ShrapnelDSP/ShrapnelPCB/d-nmj4hcd2.stp

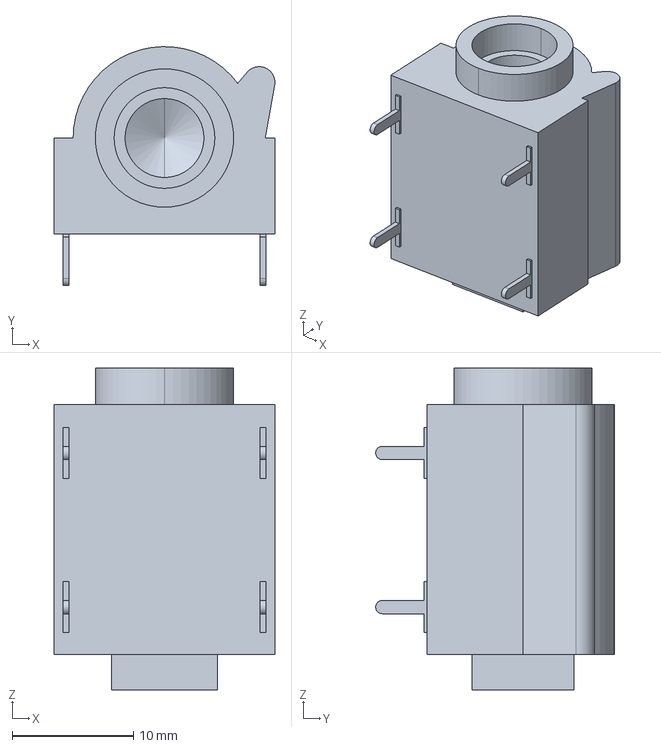
[picture p1: CAD file, 2021-09-12]
d-nmj4hcd2.stp
18.2 x 19.7 x 26.5 mm
