ShrapnelDSP/ShrapnelPCB/CUI_DEVICES_PJ-002AH-SMT-TR.step

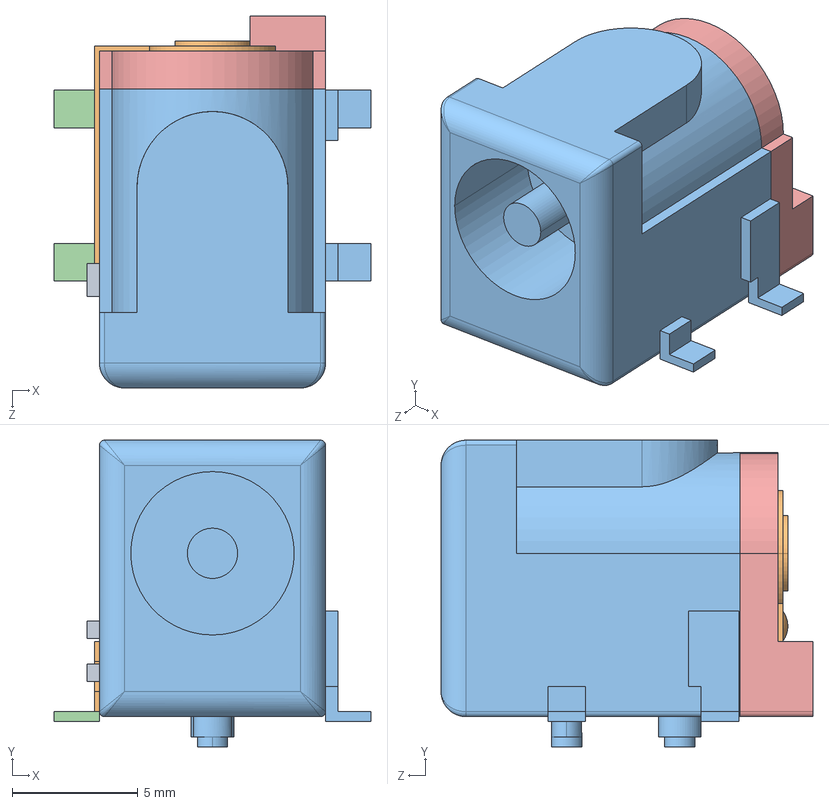
[picture p2: CAD file, 2021-09-11]
CUI_DEVICES_PJ-002AH-SMT-TR.step
12.6 x 12.2 x 14.8 mm
