ShrapnelDSP/ShrapnelPCB/57PC5F.STEP

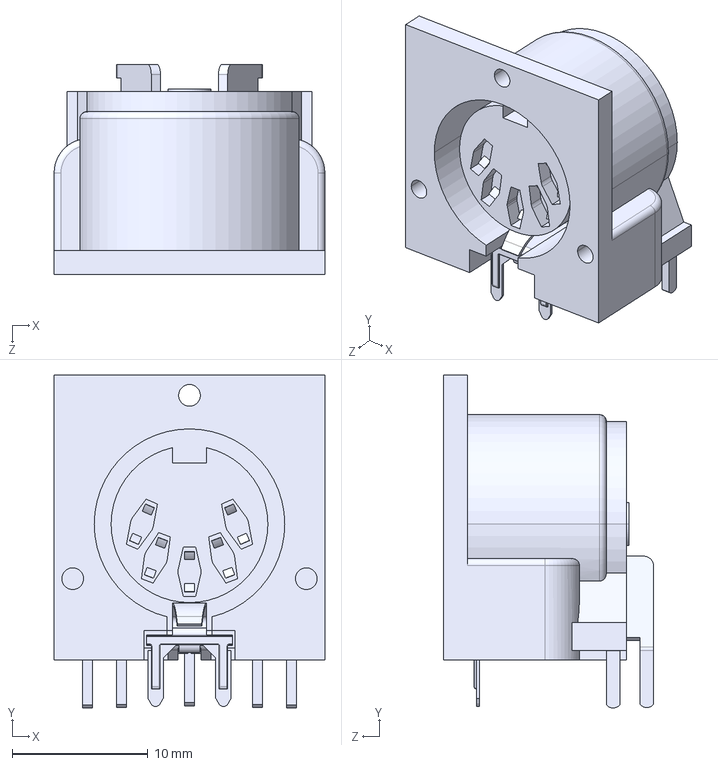
[picture p3: CAD file, 2021-08-31]
57PC5F.STEP
20.0 x 24.5 x 15.5 mm
