ShrapnelDSP/ShrapnelPCB/ESP32-Wrover-I v7.step

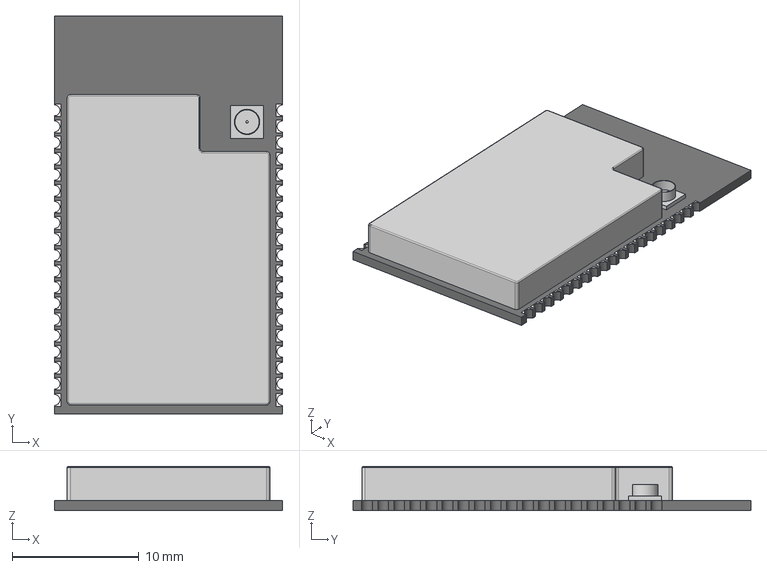
[picture p4: CAD file, 2021-08-14]
ESP32-Wrover-I v7.step
18.0 x 31.4 x 3.50 mm
