ShrapnelDSP/ShrapnelPCB/guitar_dsp_platform.kicad_pcb

## KiCad design guitar_dsp_platform.kicad_pcb (2021-10-28)

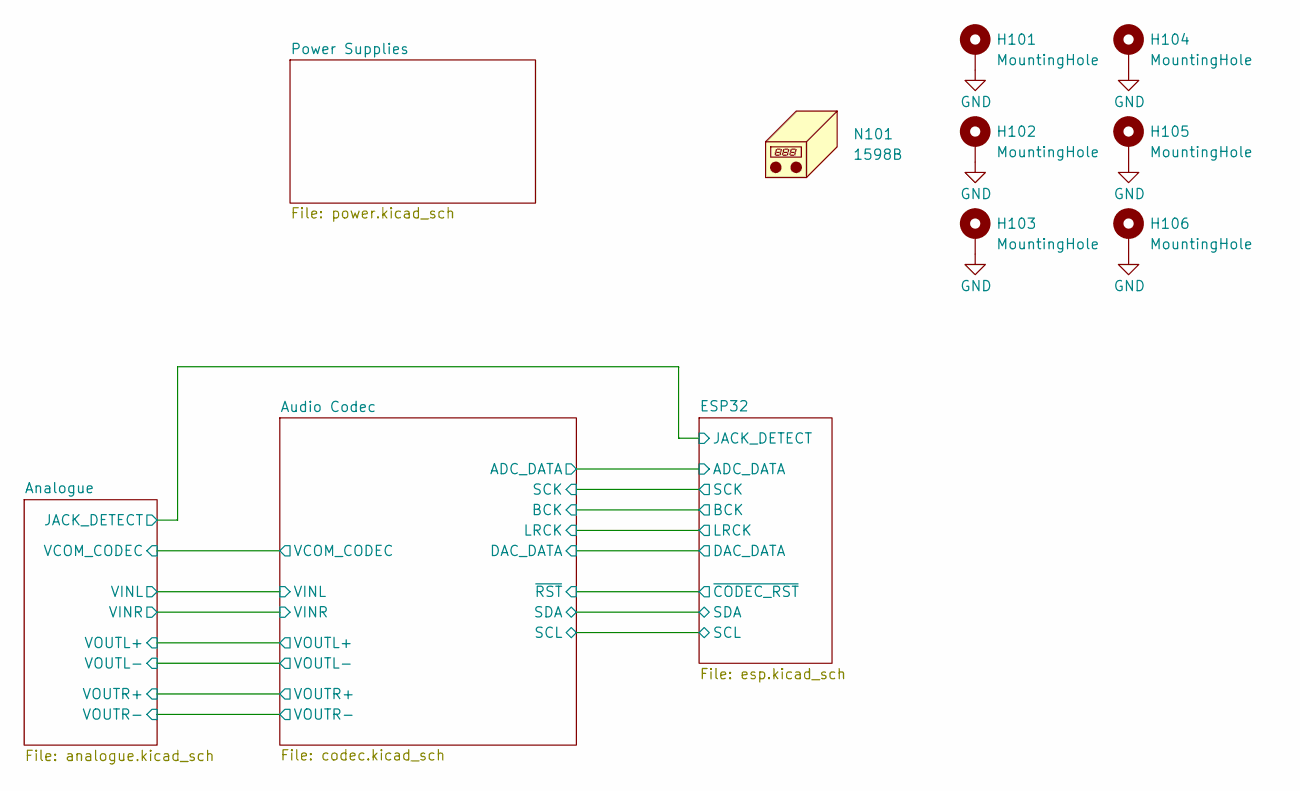
[picture p5: schematic guitar_dsp_platform.kicad_sch]

Parts:
H101, H102, H103, H104, H105, H106: MountingHole; 1598B_mounting_hole
N101: 1598B

Connections:
GND: H101.1, H102.1, H103.1, H104.1, H105.1, H106.1; also elsewhere on the board

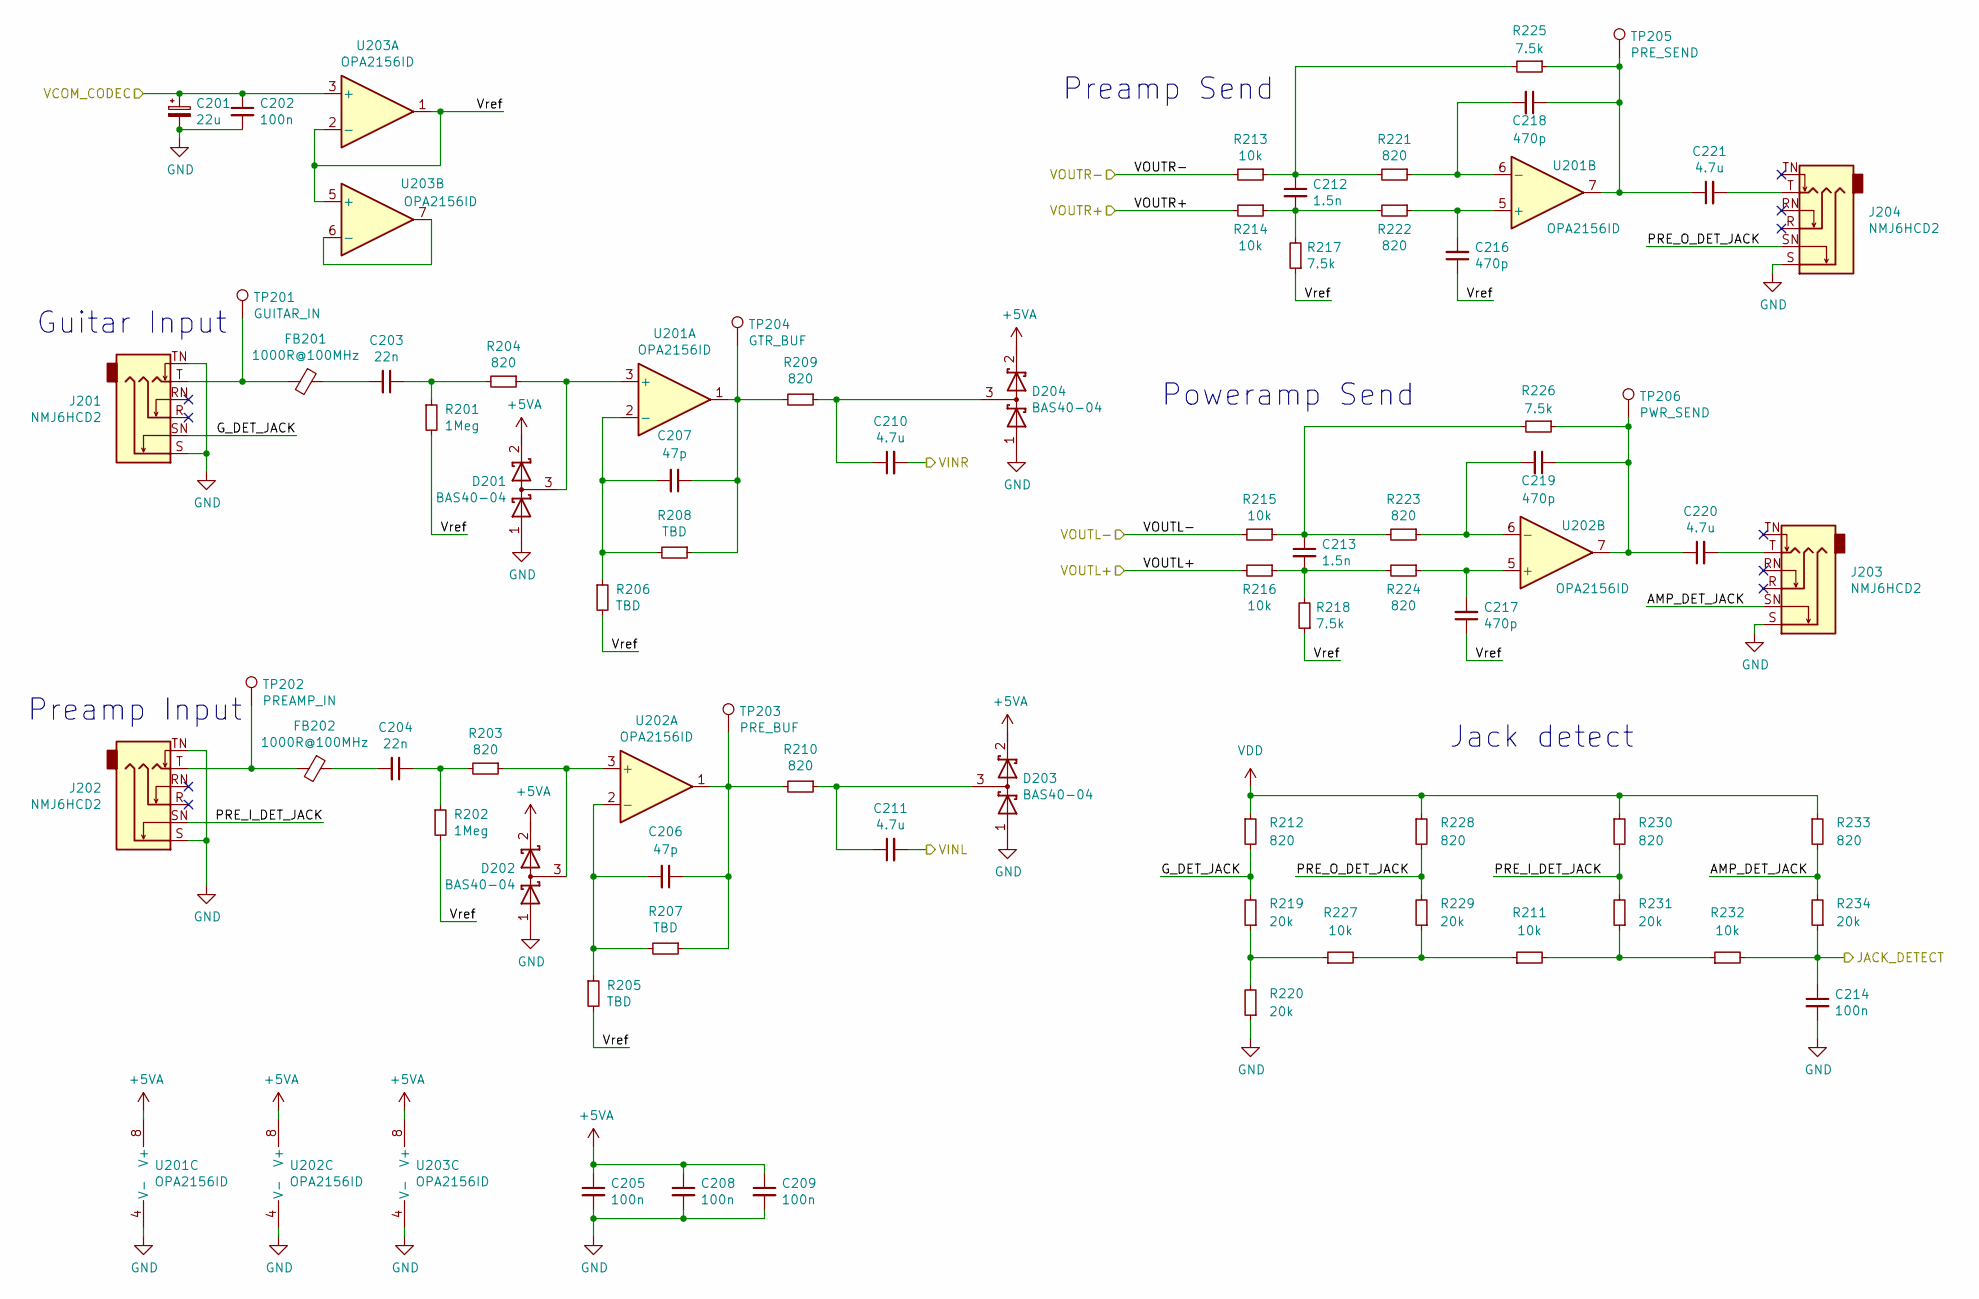
[picture p6: schematic analogue.kicad_sch]

Parts:
C201: 22u; CP_Elec_4x5.8
C202, C205, C208, C209, C214: 100n; C_0805_2012Metric_Pad1.18x1.45mm_HandSolder
C203, C204: 22n; C_0805_2012Metric_Pad1.18x1.45mm_HandSolder
C206, C207: 47p; C_0805_2012Metric_Pad1.18x1.45mm_HandSolder
C210, C211, C220, C221: 4.7u; C_Elec_4x5.8
C212, C213: 1.5n; C_0805_2012Metric_Pad1.18x1.45mm_HandSolder
C216, C217, C218, C219: 470p; C_0805_2012Metric_Pad1.18x1.45mm_HandSolder
D201, D202, D203, D204: BAS40-04; SOT-23
FB201, FB202: 1000R@100MHz; R_0805_2012Metric_Pad1.20x1.40mm_HandSolder
J201, J202, J203, J204: NMJ6HCD2; Jack_6.35mm_Neutrik_NMJ6HCD2_Horizontal
R201, R202: 1Meg; R_0805_2012Metric_Pad1.20x1.40mm_HandSolder
R203, R204, R209, R210, R212, R221, R222, R223, R224, R228, R230, R233: 820; R_0805_2012Metric_Pad1.20x1.40mm_HandSolder
R205, R206, R207, R208: TBD; R_0805_2012Metric_Pad1.20x1.40mm_HandSolder
R211, R213, R214, R215, R216, R227, R232: 10k; R_0805_2012Metric_Pad1.20x1.40mm_HandSolder
R217, R218, R225, R226: 7.5k; R_0805_2012Metric_Pad1.20x1.40mm_HandSolder
R219, R220, R229, R231, R234: 20k; R_0805_2012Metric_Pad1.20x1.40mm_HandSolder
TP201: GUITAR_IN; TestPoint_THTPad_D2.0mm_Drill1.0mm
TP202: PREAMP_IN; TestPoint_THTPad_D2.0mm_Drill1.0mm
TP203: PRE_BUF; TestPoint_THTPad_D2.0mm_Drill1.0mm
TP204: GTR_BUF; TestPoint_THTPad_D2.0mm_Drill1.0mm
TP205: PRE_SEND; TestPoint_THTPad_D2.0mm_Drill1.0mm
TP206: PWR_SEND; TestPoint_THTPad_D2.0mm_Drill1.0mm
U201, U202, U203: OPA2156ID; SOIC-8_3.9x4.9mm_P1.27mm

Connections:
+5VA: C205.1, C208.1, C209.1, D201.2 (K), D202.2 (K), D203.2 (K), D204.2 (K), U201.8 (V+), U202.8 (V+), U203.8 (V+); also elsewhere on the board
/Analogue/AMP_DET_JACK: J203.SN, R233.2, R234.2
/Analogue/G_DET_JACK: J201.SN, R212.2, R219.2
/Analogue/JACK_DETECT: C214.1, R232.2, R234.1; also elsewhere on the board
/Analogue/PRE_I_DET_JACK: J202.SN, R230.2, R231.2
/Analogue/PRE_O_DET_JACK: J204.SN, R228.2, R229.2
/Analogue/VCOM_CODEC: C201.1, C202.1, U203.3 (+); also elsewhere on the board
/Analogue/VINL: C211.2; also elsewhere on the board
/Analogue/VINR: C210.2; also elsewhere on the board
/Analogue/VOUTL+: R216.2; also elsewhere on the board
/Analogue/VOUTL-: R215.2; also elsewhere on the board
/Analogue/VOUTR+: R214.2; also elsewhere on the board
/Analogue/VOUTR-: R213.2; also elsewhere on the board
/Analogue/Vref: C216.1, C217.1, R201.2, R202.2, R205.2, R206.2, R217.1, R218.1, U203.1, U203.2 (-), U203.5 (+)
GND: C201.2, C202.2, C205.2, C208.2, C209.2, C214.2, D201.1 (A), D202.1 (A), D203.1 (A), D204.1 (A), J201.S, J201.TN, J202.S, J202.TN, J203.S, J204.S, R220.1, U201.4 (V-), U202.4 (V-), U203.4 (V-); also elsewhere on the board
unnamed: C203.1, R201.1, R204.2
unnamed: C203.2, FB201.1
unnamed: C204.1, R202.1, R203.2
unnamed: C204.2, FB202.1
unnamed: C206.1, R207.1, R210.2, TP203.1, U202.1
unnamed: C206.2, R205.1, R207.2, U202.2 (-)
unnamed: C207.1, R208.1, R209.2, TP204.1, U201.1
unnamed: C207.2, R206.1, R208.2, U201.2 (-)
unnamed: C210.1, D204.3 (common), R209.1
unnamed: C211.1, D203.3 (common), R210.1
unnamed: C212.1, R213.1, R221.2, R225.2
unnamed: C212.2, R214.1, R217.2, R222.2
unnamed: C213.1, R215.1, R223.2, R226.2
unnamed: C213.2, R216.1, R218.2, R224.2
unnamed: C216.2, R222.1, U201.5 (+)
unnamed: C217.2, R224.1, U202.5 (+)
unnamed: C218.1, C221.1, R225.1, TP205.1, U201.7
unnamed: C218.2, R221.1, U201.6 (-)
unnamed: C219.1, C220.1, R226.1, TP206.1, U202.7
unnamed: C219.2, R223.1, U202.6 (-)
unnamed: C220.2, J203.T
unnamed: C221.2, J204.T
unnamed: D201.3 (common), R204.1, U201.3 (+)
unnamed: D202.3 (common), R203.1, U202.3 (+)
unnamed: FB201.2, J201.T, TP201.1
unnamed: FB202.2, J202.T, TP202.1
unnamed: R211.1, R227.2, R229.1
unnamed: R211.2, R231.1, R232.1
unnamed: R219.1, R220.2, R227.1
unnamed: U203.6 (-), U203.7
VDD: R212.1, R228.1, R230.1, R233.1; also elsewhere on the board

Notes on the sheet:
Preamp Input
Guitar Input
Preamp Send
Poweramp Send
Jack detect

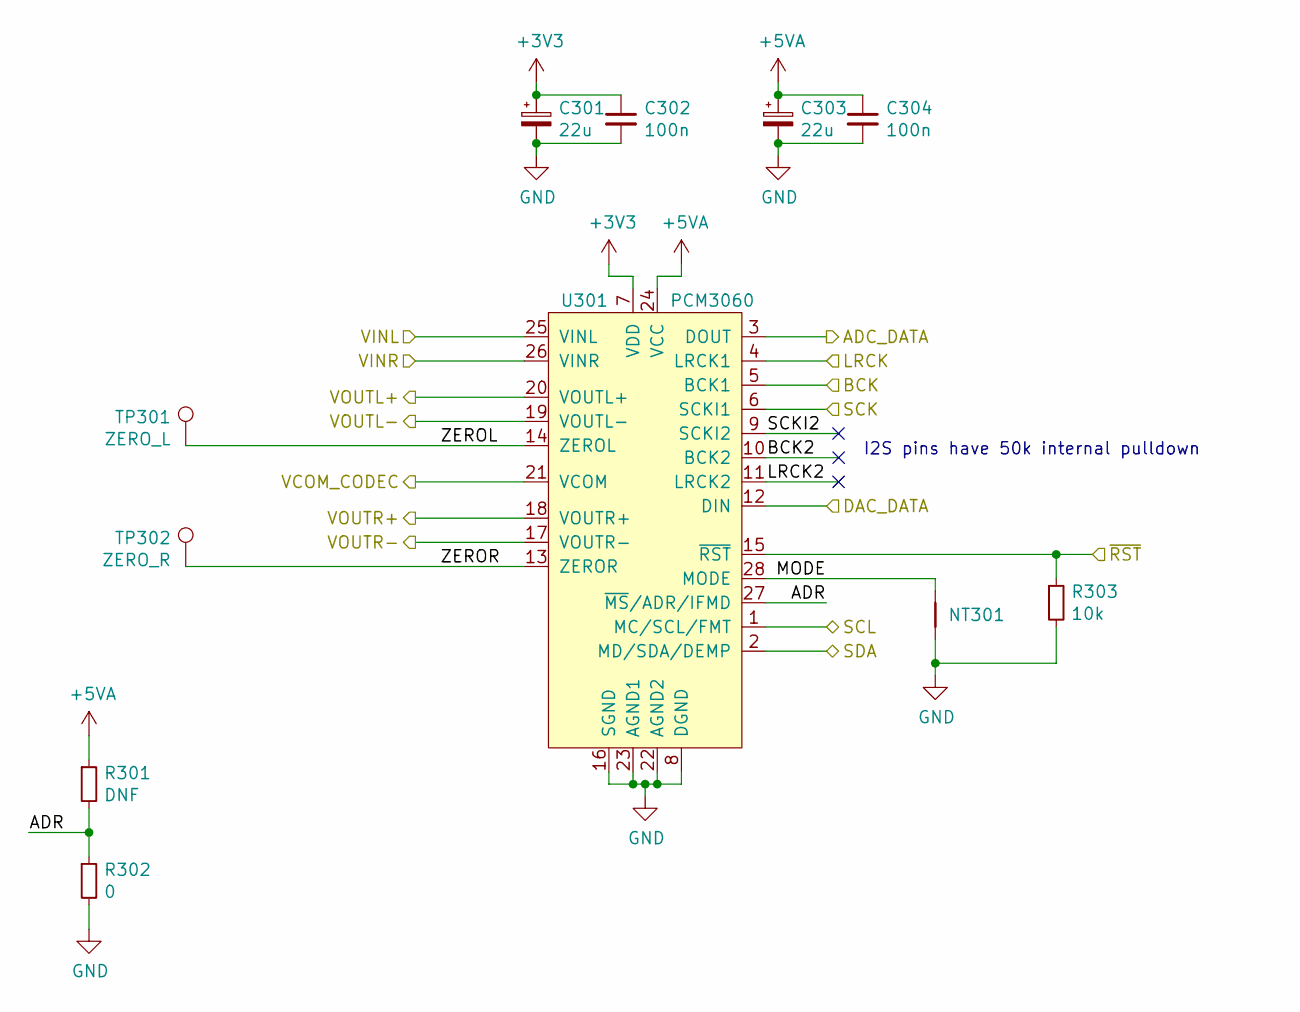
[picture p7: schematic codec.kicad_sch]

Parts:
C301, C303: 22u; CP_Elec_4x5.8
C302, C304: 100n; C_0805_2012Metric_Pad1.18x1.45mm_HandSolder
NT301: Net-Tie_2; NetTie-2_SMD_Pad0.5mm
R301: DNF; R_0805_2012Metric_Pad1.20x1.40mm_HandSolder
R302: 0; R_0805_2012Metric_Pad1.20x1.40mm_HandSolder
R303: 10k; R_0805_2012Metric_Pad1.20x1.40mm_HandSolder
TP301: ZERO_L; TestPoint_Pad_1.0x1.0mm
TP302: ZERO_R; TestPoint_Pad_1.0x1.0mm
U301: PCM3060; TSSOP-28_4.4x9.7mm_P0.65mm

Connections:
+3V3: C301.1, C302.1, U301.7 (VDD); also elsewhere on the board
+5VA: C303.1, C304.1, R301.1, U301.24 (VCC); also elsewhere on the board
/Analogue/VCOM_CODEC: U301.21 (VCOM); also elsewhere on the board
/Analogue/VINL: U301.25 (VINL); also elsewhere on the board
/Analogue/VINR: U301.26 (VINR); also elsewhere on the board
/Analogue/VOUTL+: U301.20 (VOUTL+); also elsewhere on the board
/Analogue/VOUTL-: U301.19 (VOUTL-); also elsewhere on the board
/Analogue/VOUTR+: U301.18 (VOUTR+); also elsewhere on the board
/Analogue/VOUTR-: U301.17 (VOUTR-); also elsewhere on the board
/Audio Codec/ADC_DATA: U301.3 (DOUT); also elsewhere on the board
/Audio Codec/ADR: R301.2, R302.1, U301.27 (~MS/ADR/IFMD)
/Audio Codec/BCK2: U301.10 (BCK2)
/Audio Codec/LRCK2: U301.11 (LRCK2)
/Audio Codec/MODE: NT301.2, U301.28 (MODE)
/Audio Codec/SCKI2: U301.9 (SCKI2)
/Audio Codec/ZEROL: TP301.1, U301.14 (ZEROL)
/Audio Codec/ZEROR: TP302.1, U301.13 (ZEROR)
/Audio Codec/~RST: R303.1, U301.15 (~RST); also elsewhere on the board
/ESP32/BCK: U301.5 (BCK1); also elsewhere on the board
/ESP32/DAC_DATA: U301.12 (DIN); also elsewhere on the board
/ESP32/LRCK: U301.4 (LRCK1); also elsewhere on the board
/ESP32/SCK: U301.6 (SCKI1); also elsewhere on the board
/ESP32/SCL: U301.1 (MC/SCL/FMT); also elsewhere on the board
/ESP32/SDA: U301.2 (MD/SDA/DEMP); also elsewhere on the board
GND: C301.2, C302.2, C303.2, C304.2, NT301.1, R302.2, R303.2, U301.8 (DGND), U301.16 (SGND), U301.22 (AGND2), U301.23 (AGND1); also elsewhere on the board

Notes on the sheet:
I2S pins have 50k internal pulldown

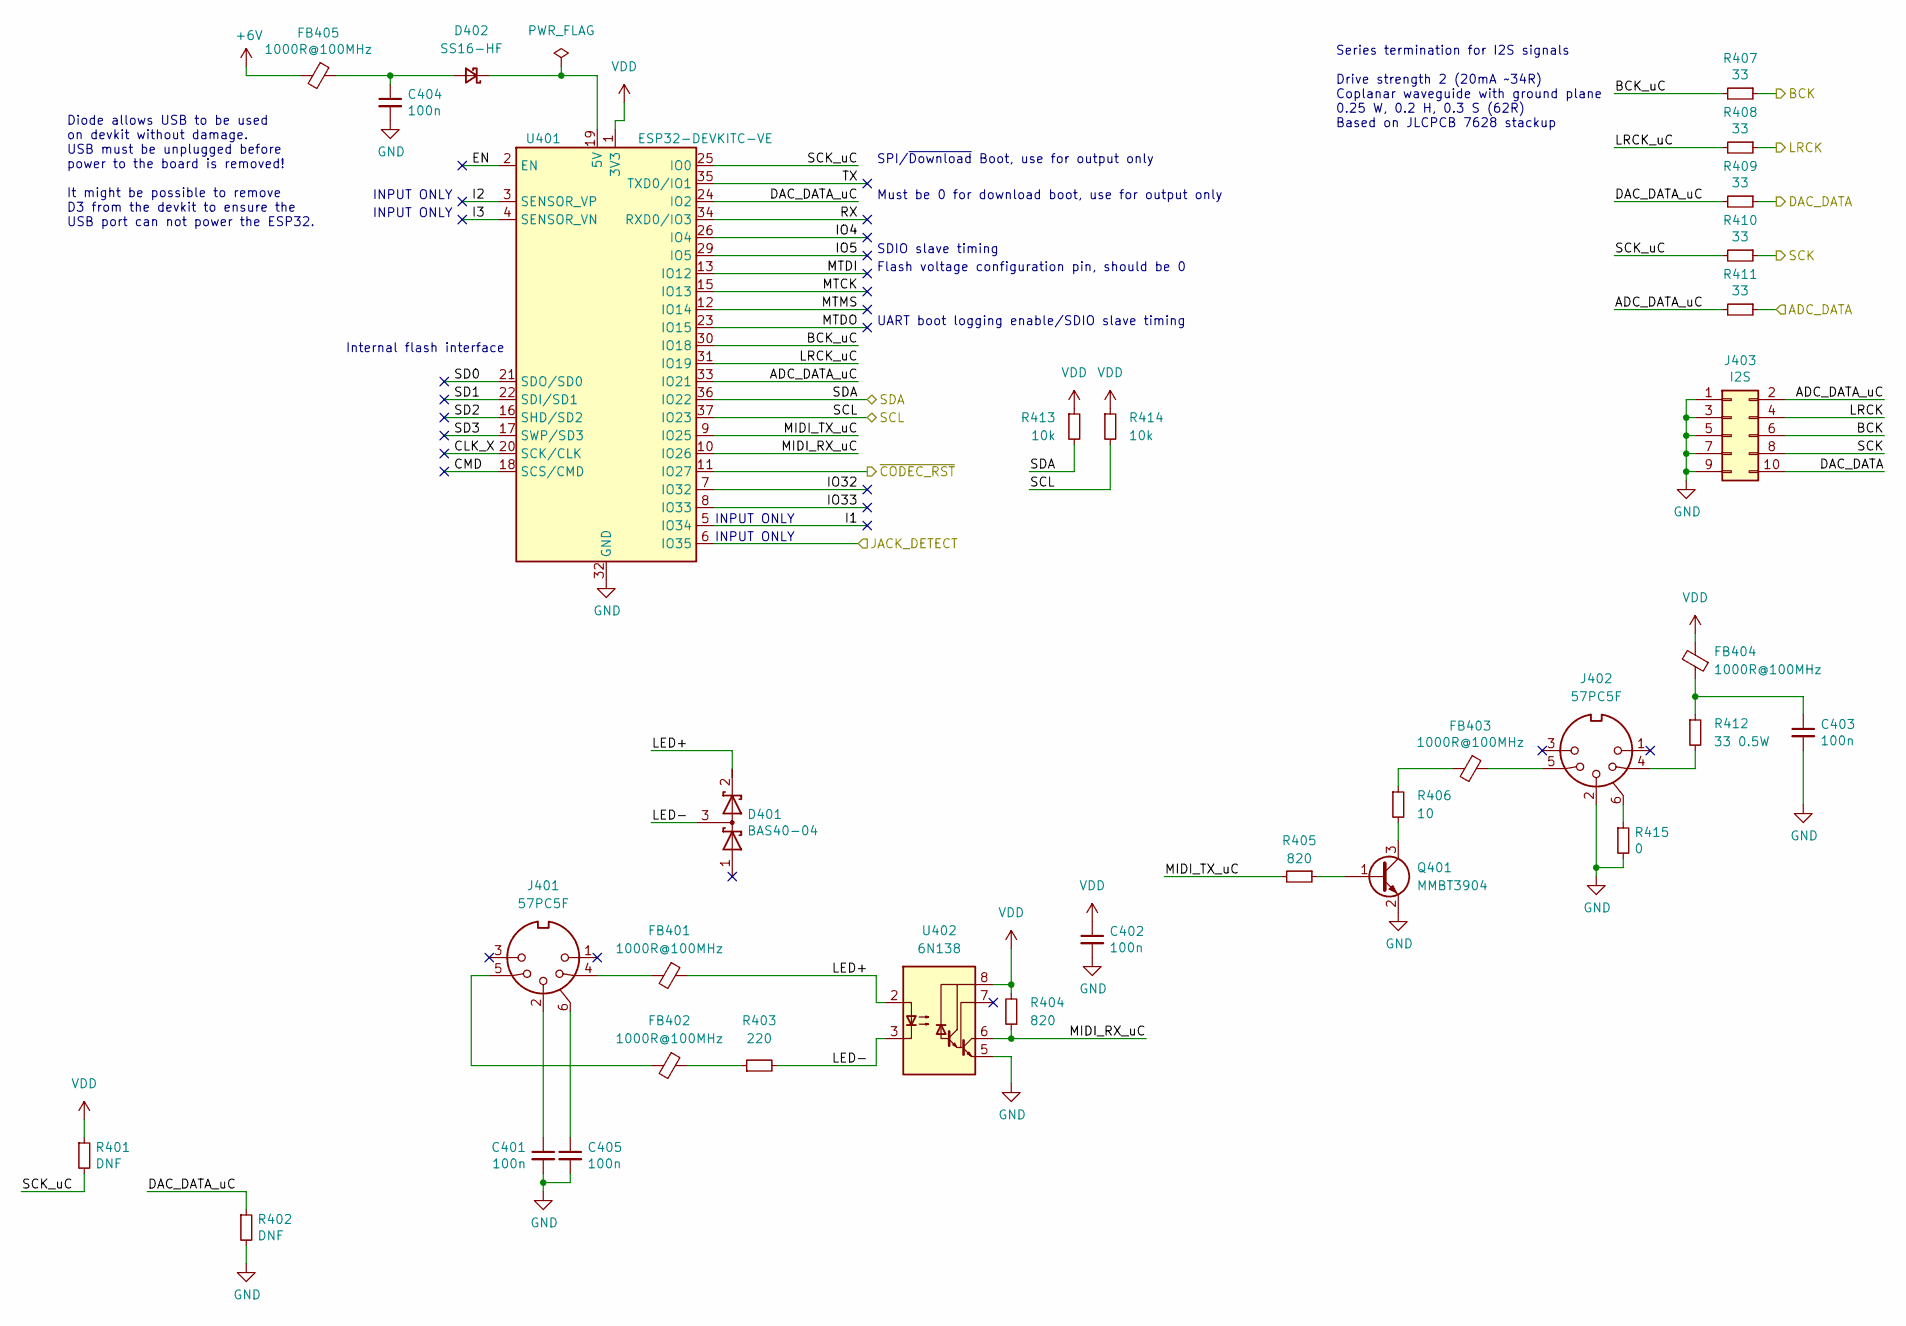
[picture p8: schematic esp.kicad_sch]

Parts:
C401, C402, C403, C404, C405: 100n; C_0805_2012Metric_Pad1.18x1.45mm_HandSolder
D401: BAS40-04; SOT-23
D402: SS16-HF; D_SMA_Handsoldering
FB401, FB402, FB403, FB404, FB405: 1000R@100MHz; R_0805_2012Metric_Pad1.20x1.40mm_HandSolder
J401, J402: 57PC5F
J403: I2S; PinHeader_2x05_P2.54mm_Vertical
Q401: MMBT3904; SOT-23
R401, R402: DNF; R_0805_2012Metric_Pad1.20x1.40mm_HandSolder
R403: 220; R_0805_2012Metric_Pad1.20x1.40mm_HandSolder
R404, R405: 820; R_0805_2012Metric_Pad1.20x1.40mm_HandSolder
R406: 10; R_0805_2012Metric_Pad1.20x1.40mm_HandSolder
R407, R408, R409, R410, R411: 33; R_0805_2012Metric_Pad1.20x1.40mm_HandSolder
R412: 33 0.5W; R_1206_3216Metric_Pad1.30x1.75mm_HandSolder
R413, R414: 10k; R_0805_2012Metric_Pad1.20x1.40mm_HandSolder
R415: 0; R_0805_2012Metric_Pad1.20x1.40mm_HandSolder
U401: ESP32-DEVKITC-VE; ESP32_DevkitC
U402: 6N138; DIP-8_W8.89mm_SMDSocket_LongPads

Connections:
+6V: FB405.2; also elsewhere on the board
/Analogue/JACK_DETECT: U401.6 (IO35); also elsewhere on the board
/Audio Codec/ADC_DATA: R411.1; also elsewhere on the board
/Audio Codec/~RST: U401.11 (IO27); also elsewhere on the board
/ESP32/ADC_DATA_uC: J403.2, R411.2, U401.33 (IO21)
/ESP32/BCK: J403.6, R407.1; also elsewhere on the board
/ESP32/BCK_uC: R407.2, U401.30 (IO18)
/ESP32/CLK_X: U401.20 (SCK/CLK)
/ESP32/CMD: U401.18 (SCS/CMD)
/ESP32/DAC_DATA: J403.10, R409.1; also elsewhere on the board
/ESP32/DAC_DATA_uC: R402.1, R409.2, U401.24 (IO2)
/ESP32/EN: U401.2 (EN)
/ESP32/I1: U401.5 (IO34)
/ESP32/I2: U401.3 (SENSOR_VP)
/ESP32/I3: U401.4 (SENSOR_VN)
/ESP32/IO4: U401.26 (IO4)
/ESP32/IO5: U401.29 (IO5)
/ESP32/IO32: U401.7 (IO32)
/ESP32/IO33: U401.8 (IO33)
/ESP32/LED+: D401.2 (K), FB401.1, U402.2 (C1)
/ESP32/LED-: D401.3 (common), R403.2, U402.3 (C2)
/ESP32/LRCK: J403.4, R408.1; also elsewhere on the board
/ESP32/LRCK_uC: R408.2, U401.31 (IO19)
/ESP32/MIDI_RX_uC: R404.1, U401.10 (IO26), U402.6 (VO2)
/ESP32/MIDI_TX_uC: R405.2, U401.9 (IO25)
/ESP32/MTCK: U401.15 (IO13)
/ESP32/MTDI: U401.13 (IO12)
/ESP32/MTDO: U401.23 (IO15)
/ESP32/MTMS: U401.12 (IO14)
/ESP32/RX: U401.34 (RXD0/IO3)
/ESP32/SCK: J403.8, R410.1; also elsewhere on the board
/ESP32/SCK_uC: R401.2, R410.2, U401.25 (IO0)
/ESP32/SCL: R414.2, U401.37 (IO23); also elsewhere on the board
/ESP32/SD0: U401.21 (SDO/SD0)
/ESP32/SD1: U401.22 (SDI/SD1)
/ESP32/SD2: U401.16 (SHD/SD2)
/ESP32/SD3: U401.17 (SWP/SD3)
/ESP32/SDA: R413.2, U401.36 (IO22); also elsewhere on the board
/ESP32/TX: U401.35 (TXD0/IO1)
GND: C401.2, C402.2, C403.2, C404.2, C405.2, J402.2, J403.1, J403.3, J403.5, J403.7, J403.9, Q401.2 (E), R402.2, R415.2, U401.14 (GND), U401.32 (GND), U401.38 (GND), U402.5 (GND); also elsewhere on the board
unnamed: C401.1, J401.2
unnamed: C403.1, FB404.1, R412.1
unnamed: C404.1, D402.2 (A), FB405.1
unnamed: C405.1, J401.6, J401.7
unnamed: D402.1 (K), U401.19 (5V)
unnamed: FB401.2, J401.4
unnamed: FB402.1, R403.1
unnamed: FB402.2, J401.5
unnamed: FB403.1, J402.5
unnamed: FB403.2, R406.1
unnamed: J402.4, R412.2
unnamed: J402.6, J402.7, R415.1
unnamed: Q401.1 (B), R405.1
unnamed: Q401.3 (C), R406.2
VDD: C402.1, FB404.2, R401.1, R404.2, R413.1, R414.1, U401.1 (3V3), U402.8 (VCC); also elsewhere on the board

Notes on the sheet:
Diode allows USB to be used on devkit without damage. USB must be unplugged before power to the board is removed! It might be possible to remove D3 from the devkit to ensure the USB port can not power the ESP32.
Internal flash interface
INPUT ONLY
SPI/~{Download} Boot, use for output only
Must be 0 for download boot, use for output only
SDIO slave timing
Flash voltage configuration pin, should be 0
UART boot logging enable/SDIO slave timing
Series termination for I2S signals Drive strength 2 (20mA ~34R) Coplanar waveguide with ground plane 0.25 W, 0.2 H, 0.3 S (62R) Based on JLCPCB 7628 stackup

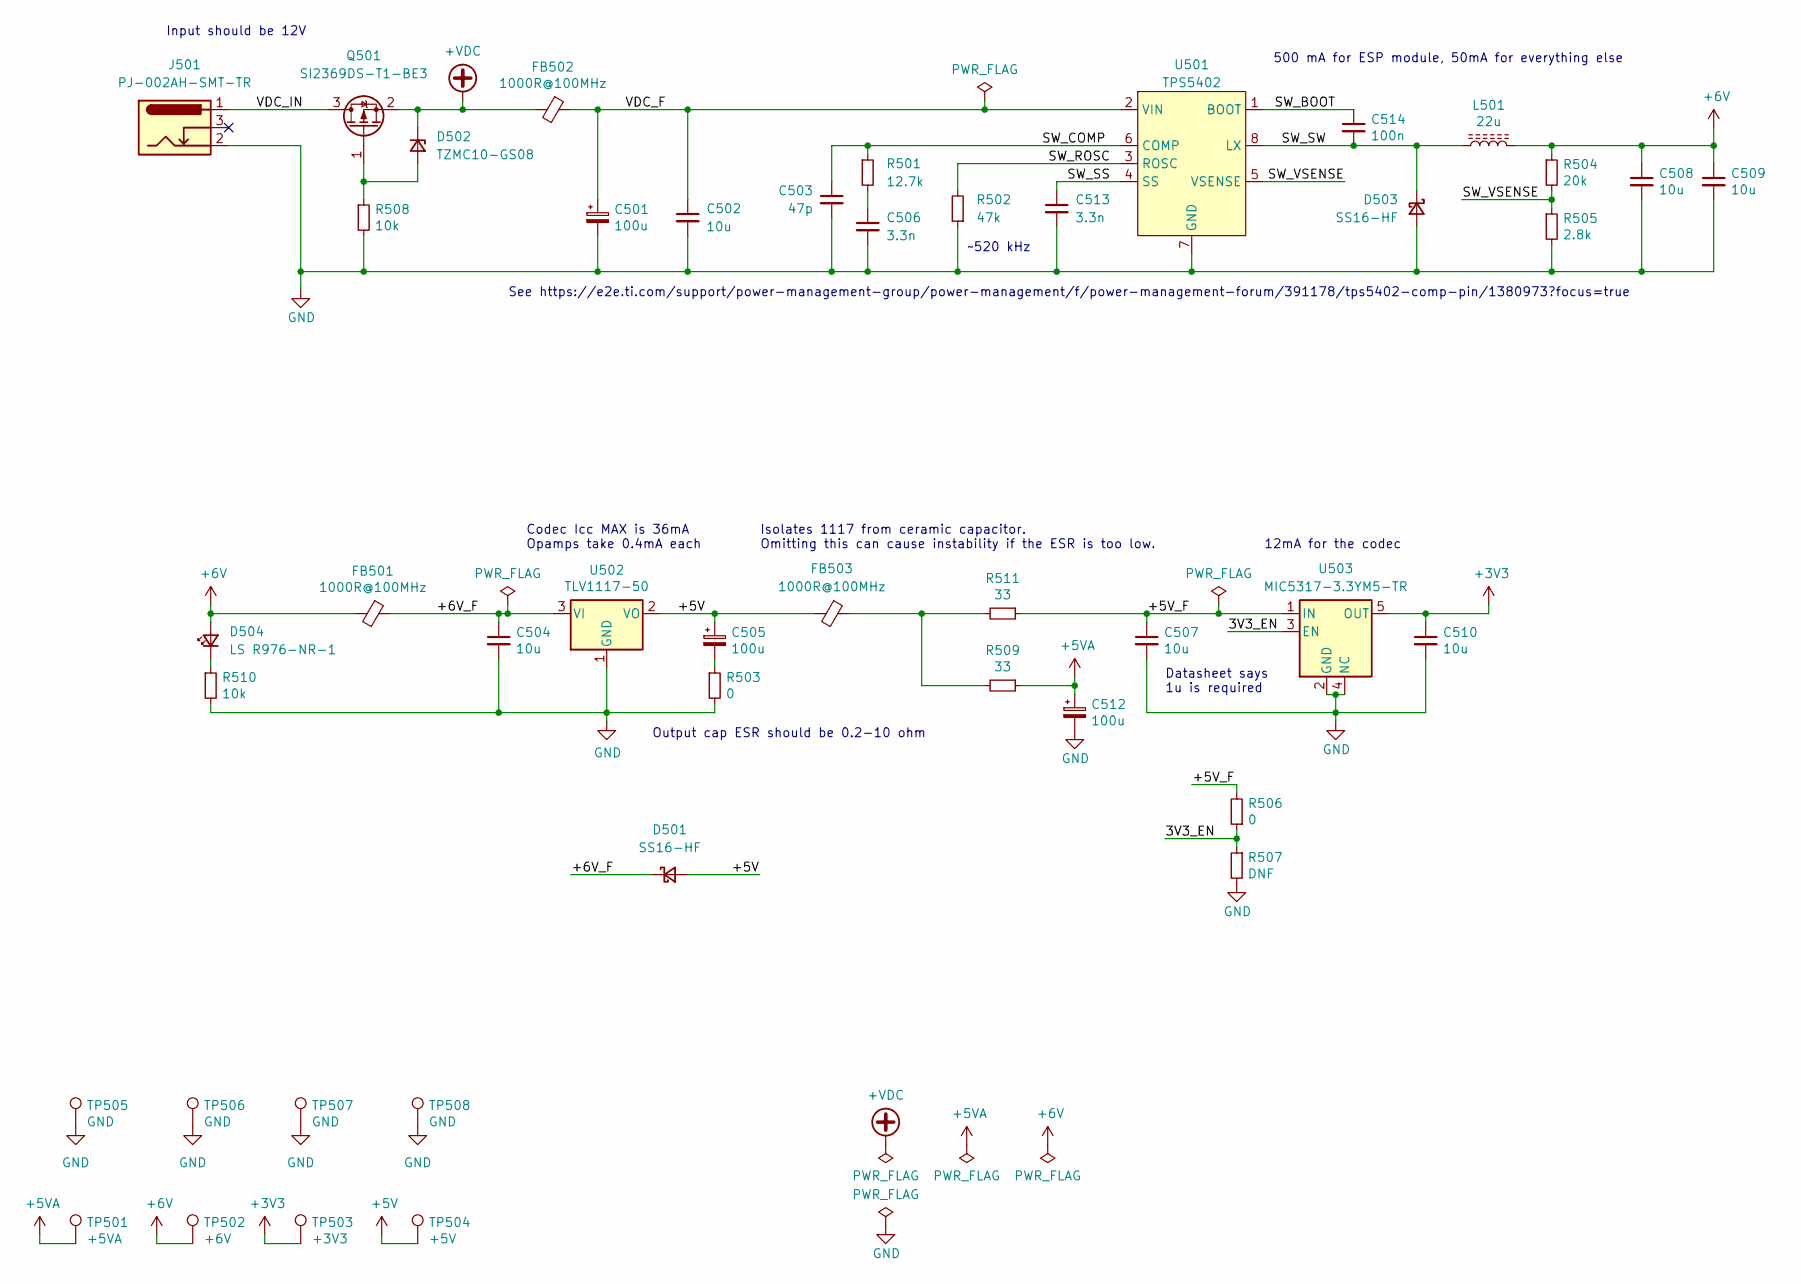
[picture p9: schematic power.kicad_sch]

Parts:
C501, C505, C512: 100u; CP_Elec_6.3x7.7
C502, C504, C507, C508, C509, C510: 10u; C_0805_2012Metric_Pad1.18x1.45mm_HandSolder
C503: 47p; C_0805_2012Metric_Pad1.18x1.45mm_HandSolder
C506, C513: 3.3n; C_0805_2012Metric_Pad1.18x1.45mm_HandSolder
C514: 100n; C_0805_2012Metric_Pad1.18x1.45mm_HandSolder
D501, D503: SS16-HF; D_SMA_Handsoldering
D502: TZMC10-GS08; D_MiniMELF
D504: LS R976-NR-1; LED_0805_2012Metric_Castellated
FB501, FB502, FB503: 1000R@100MHz; R_0805_2012Metric_Pad1.20x1.40mm_HandSolder
J501: PJ-002AH-SMT-TR; CUI_PJ-002AH-SMT-TR
L501: 22u; L_Taiyo-Yuden_NR-50xx_HandSoldering
Q501: SI2369DS-T1-BE3; SOT-23
R501: 12.7k; R_0805_2012Metric_Pad1.20x1.40mm_HandSolder
R502: 47k; R_0805_2012Metric_Pad1.20x1.40mm_HandSolder
R503, R506: 0; R_0805_2012Metric_Pad1.20x1.40mm_HandSolder
R504: 20k; R_0805_2012Metric_Pad1.20x1.40mm_HandSolder
R505: 2.8k; R_0805_2012Metric_Pad1.20x1.40mm_HandSolder
R507: DNF; R_0805_2012Metric_Pad1.20x1.40mm_HandSolder
R508, R510: 10k; R_0805_2012Metric_Pad1.20x1.40mm_HandSolder
R509, R511: 33; R_0805_2012Metric_Pad1.20x1.40mm_HandSolder
TP501: +5VA; TestPoint_THTPad_D2.0mm_Drill1.0mm
TP502: +6V; TestPoint_THTPad_D2.0mm_Drill1.0mm
TP503: +3V3; TestPoint_THTPad_D2.0mm_Drill1.0mm
TP504: +5V; TestPoint_THTPad_D2.0mm_Drill1.0mm
TP505, TP506, TP507, TP508: GND; TestPoint_THTPad_D2.0mm_Drill1.0mm
U501: TPS5402; SOIC-8_3.9x4.9mm_P1.27mm
U502: TLV1117-50; SOT-223-3_TabPin2
U503: MIC5317-3.3YM5-TR; SOT-23-5_HandSoldering

Connections:
+3V3: C510.1, TP503.1, U503.5 (OUT); also elsewhere on the board
+5V: C505.1, D501.2 (A), FB503.2, TP504.1, U502.2 (VO)
+5VA: C512.1, R509.1, TP501.1; also elsewhere on the board
+6V: C508.1, C509.1, D504.2 (A), FB501.2, L501.2, R504.1, TP502.1; also elsewhere on the board
+VDC: D502.1 (K), FB502.2, Q501.2 (S)
/Power Supplies/3V3_EN: R506.1, R507.1, U503.3 (EN)
/Power Supplies/+5V_F: C507.1, R506.2, R511.1, U503.1 (IN)
/Power Supplies/+6V_F: C504.1, D501.1 (K), FB501.1, U502.3 (VI)
/Power Supplies/SW_BOOT: C514.1, U501.1 (BOOT)
/Power Supplies/SW_COMP: C503.1, R501.1, U501.6 (COMP)
/Power Supplies/SW_ROSC: R502.2, U501.3 (ROSC)
/Power Supplies/SW_SS: C513.1, U501.4 (SS)
/Power Supplies/SW_SW: C514.2, D503.1 (K), L501.1, U501.8 (LX)
/Power Supplies/SW_VSENSE: R504.2, R505.1, U501.5 (VSENSE)
/Power Supplies/VDC_F: C501.1, C502.1, FB502.1, U501.2 (VIN)
/Power Supplies/VDC_IN: J501.1, Q501.3 (D)
GND: C501.2, C502.2, C503.2, C504.2, C506.2, C507.2, C508.2, C509.2, C510.2, C512.2, C513.2, D503.2 (A), J501.2, R502.1, R503.2, R505.2, R507.2, R508.2, R510.2, TP505.1, TP506.1, TP507.1, TP508.1, U501.7 (GND), U502.1 (GND), U503.2 (GND), U503.4 (NC); also elsewhere on the board
unnamed: C505.2, R503.1
unnamed: C506.1, R501.2
unnamed: D502.2 (A), Q501.1 (G), R508.1
unnamed: D504.1 (K), R510.1
unnamed: FB503.1, R509.2, R511.2

Notes on the sheet:
Input should be 12V
See https://e2e.ti.com/support/power-management-group/power-management/f/power-management-forum/391178/tps5402-comp-pin/1380973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
Codec Icc MAX is 36mA Opamps take 0.4mA each
Output cap ESR should be 0.2-10 ohm
Isolates 1117 from ceramic capacitor. Omitting this can cause instability if the ESR is too low.
~520 kHz
Datasheet says 1u is required
12mA for the codec
500 mA for ESP module, 50mA for everything else

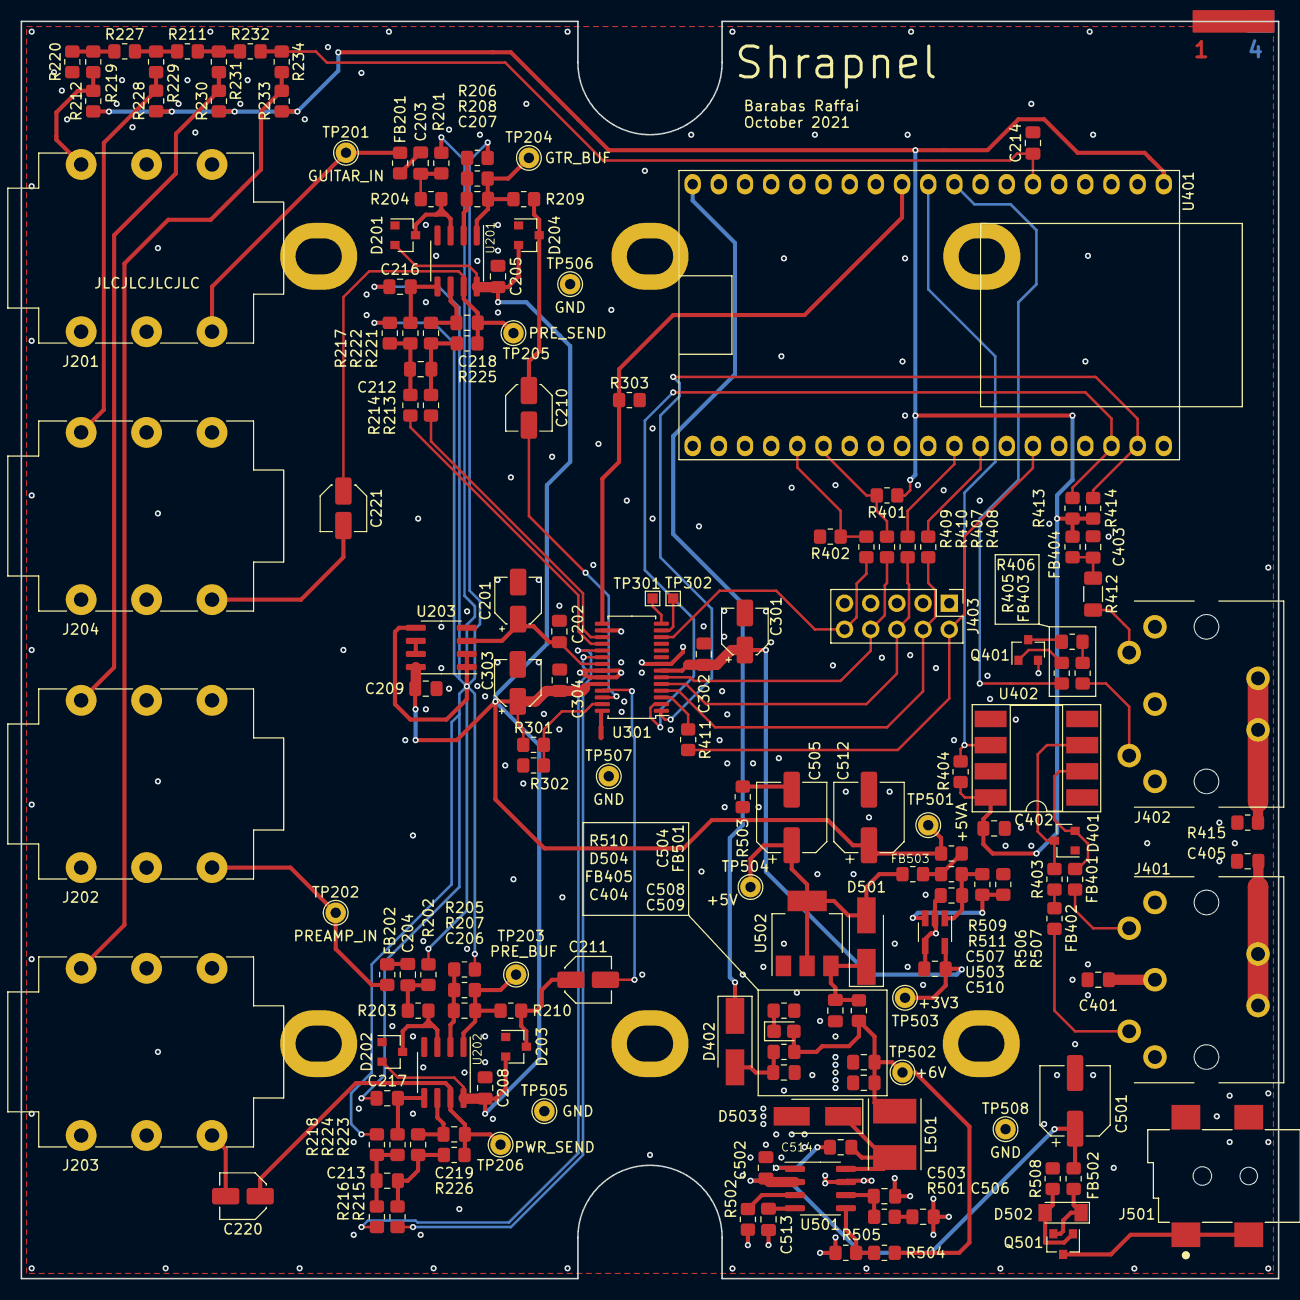
[picture p10: board guitar_dsp_platform.kicad_pcb from above]

Board: 4 copper layers, 122.0 x 122.0 mm, 168 parts (0 on the bottom side), 101 nets.
