ShrapnelDSP/ShrapnelPCB/(commit log)

2021-08-31 Add MIDI, convert to nightly kicad
    [57PC5F.STEP, analogue.kicad_sch, codec.kicad_sch, esp.kicad_sch, guitar_dsp_platform.kicad_pcb, guitar_dsp_platform.kicad_sch, power.kicad_sch]
2021-09-05 Working on schematic
    [analogue.kicad_sch, esp.kicad_sch, guitar_dsp_platform.kicad_pcb, guitar_dsp_platform.kicad_sch, power.kicad_sch]
2021-09-06 Review PSU, add footprints for all components
    [analogue.kicad_sch, codec.kicad_sch, esp.kicad_sch, guitar_dsp_platform.kicad_pcb, guitar_dsp_platform.kicad_sch, power.kicad_sch]
2021-09-07 Tweak layout
    [analogue.kicad_sch, codec.kicad_sch, esp.kicad_sch, guitar_dsp_platform.kicad_pcb, power.kicad_sch]
2021-09-11 Schematic reviewed, assign PN to all parts
    [CUI_DEVICES_PJ-002AH-SMT-TR.step, analogue.kicad_sch, codec.kicad_sch, esp.kicad_sch, guitar_dsp_platform.kicad_sch, power.kicad_sch]
2021-09-11 Start BOM tidy up
    [analogue.kicad_sch, guitar_dsp_platform.kicad_sch, power.kicad_sch]
2021-09-12 Update 3D models to work with FreeCAD StepUp plugin
    [d-nmj4hcd2.stp, guitar_dsp_platform.kicad_pcb]
2021-09-12 Update some part numbers for in-stock parts
    [analogue.kicad_sch, codec.kicad_sch, esp.kicad_sch, guitar_dsp_platform.kicad_sch, power.kicad_sch]
2021-09-18 WIP substitute parts
    [guitar_dsp_platform.kicad_sch, power.kicad_sch]
2021-09-18 Add new switchmode power supply
    [esp.kicad_sch, guitar_dsp_platform.kicad_sch, power.kicad_sch]
2021-09-19 Complete power supply design
    [analogue.kicad_sch, guitar_dsp_platform.kicad_sch, power.kicad_sch]
2021-09-20 Ready for layout
    [analogue.kicad_sch, codec.kicad_sch, esp.kicad_sch, guitar_dsp_platform.kicad_pcb, guitar_dsp_platform.kicad_sch, power.kicad_sch]
2021-09-20 Layout first draft
    [codec.kicad_sch, esp.kicad_sch, guitar_dsp_platform.kicad_pcb, guitar_dsp_platform.kicad_sch]
2021-09-25 Mechanical tweaks of I/O
    [guitar_dsp_platform.kicad_pcb]
2021-09-28 Clean up layout, add testpoints, layer markers
    [codec.kicad_sch, esp.kicad_sch, guitar_dsp_platform.kicad_pcb, guitar_dsp_platform.kicad_sch, power.kicad_sch]
2021-09-29 Minor layout tweaks
    [guitar_dsp_platform.kicad_pcb]
2021-10-14 Final BOM changes
    [analogue.kicad_sch, codec.kicad_sch, esp.kicad_sch, guitar_dsp_platform.kicad_sch, power.kicad_sch]
2021-10-17 Tweak mechanical design
    1/4 inch jacks are now flush with the faceplate. Reduced the gap between
    MIDI jack and back faceplate.
    [analogue.kicad_sch, codec.kicad_sch, esp.kicad_sch, guitar_dsp_platform.kicad_pcb, power.kicad_sch]
2021-10-22 Adjust jack position after mechanical checks
    Jacks will require two internal 1.2mm washers, and the external washer
    supplied with the jacks.
    [guitar_dsp_platform.kicad_pcb]
2021-10-26 Resolve some issues
    - Add missing MIDI connector pins to symbol
    - Isolate low-ESR capacitors from 1117
    - Fix DRC errors in footprints
    [analogue.kicad_sch, codec.kicad_sch, esp.kicad_sch, guitar_dsp_platform.kicad_pcb, guitar_dsp_platform.kicad_sch, power.kicad_sch]
2021-10-26 Add silkscreen lines for mounting screw keep-out
    [guitar_dsp_platform.kicad_pcb]
2021-10-28 Exports setup for JLCPCB
    [guitar_dsp_platform.kicad_pcb]
2021-10-28 Replace mounting holes with plated slots
    [guitar_dsp_platform.kicad_pcb, guitar_dsp_platform.kicad_sch]
2021-11-09 Fix incorrect part number
    [analogue.kicad_sch, codec.kicad_sch, esp.kicad_sch, power.kicad_sch]
